FabLabCasaCorsini/aqp_sensors/README.md

# aqp_sensors
Software components for the Aquaponic project - Forked in Casa Corsini github
