FabLabCasaCorsini/aqp_sensors/hydra open souce project/v.02/Hydra OSP.brd

## EAGLE design hydra open souce project/v.02/Hydra OSP.brd (2017-07-12)

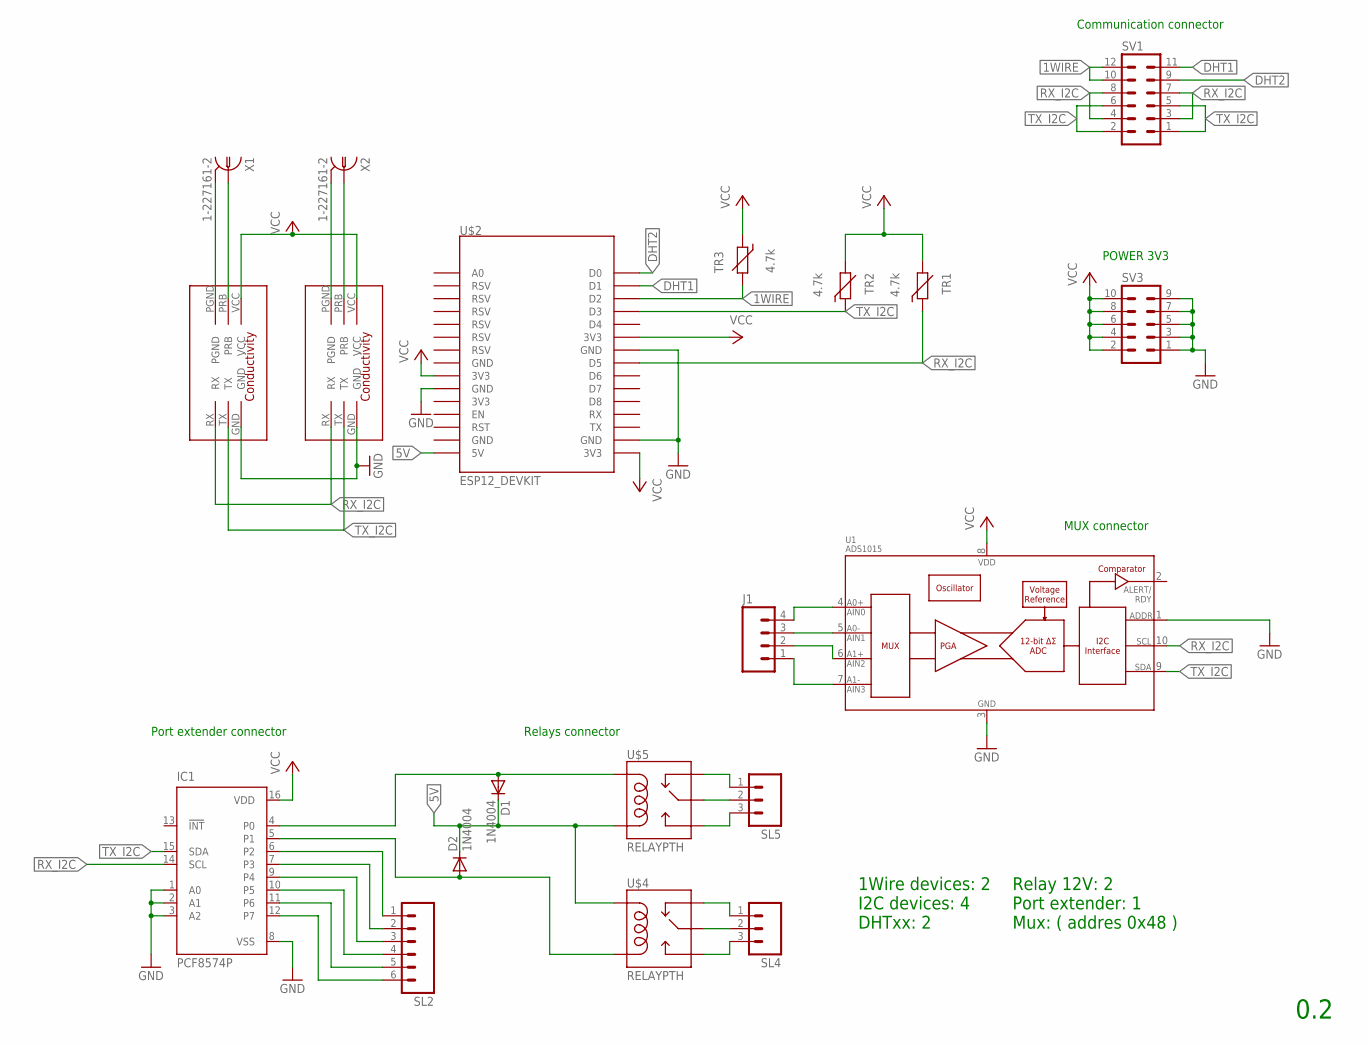
[picture p1: schematic Hydra OSP.sch]

Parts:
D1, D2: 1N4004; DO41-10
IC1: PCF8574P; DIL16
J1: M04LOCK; 1X04_LOCK
SL2: M06; 06P
SL4, SL5: M03; 03P
SV1: MA06-2
SV3: MA05-2
TR1, TR2, TR3: 4.7k; R-5
U1: ADS1015; MSOP10
U$1, U$3: ATLSCI_COND; ATLAS_SCI_COND
U$2: ESP12_DEVKIT
U$4, U$5: RELAYPTH; SRD-05VDC-SL-C
X1, X2: 1-227161-2; AMP_227161

Connections:
1WIRE: SV1.10, SV1.12, TR3.2, U$2.D2
5V: D1.C, D2.C, U$2.5V, U$4.COIL1, U$5.COIL0
DHT1: SV1.11, U$2.D1
DHT2: SV1.9, U$2.D0
GND: IC1.1 (A0), IC1.2 (A1), IC1.3 (A2), IC1.8 (VSS), SV3.1, SV3.3, SV3.5, SV3.7, SV3.9, U1.1 (ADDR), U1.3 (VSS), U$1.GND, U$2.GND@0 (GND), U$2.GND@2 (GND), U$2.GND@3 (GND), U$3.GND
unnamed: U$1.PGND, X1.2
unnamed: U$1.PRB, X1.1
unnamed: U$3.PRB, X2.1
unnamed: U$3.PGND, X2.2
unnamed: D1.A, IC1.4 (P0), U$5.COIL1
unnamed: D2.A, IC1.5 (P1), U$4.COIL0
unnamed: SL4.1, U$4.SWCLOSED (SWCLOSE)
unnamed: SL4.2, U$4.SWCOMMON
unnamed: J1.4, U1.4 (AIN0)
unnamed: J1.3, U1.5 (AIN1)
unnamed: J1.2, U1.6 (AIN2)
unnamed: J1.1, U1.7 (AIN3)
unnamed: IC1.6 (P2), SL2.1
unnamed: IC1.7 (P3), SL2.2
unnamed: IC1.9 (P4), SL2.3
unnamed: IC1.10 (P5), SL2.4
unnamed: IC1.11 (P6), SL2.5
unnamed: IC1.12 (P7), SL2.6
unnamed: SL4.3, U$4.SWOPEN
unnamed: SL5.1, U$5.SWCLOSED (SWCLOSE)
unnamed: SL5.2, U$5.SWCOMMON
unnamed: SL5.3, U$5.SWOPEN
RX_I2C: IC1.14 (SCL), SV1.3, SV1.4, SV1.7, SV1.8, TR1.1, U1.10 (SCL), U$1.RX, U$2.D5, U$3.RX
TX_I2C: IC1.15 (SDA), SV1.1, SV1.2, SV1.5, SV1.6, TR2.1, U1.9 (SDA), U$1.TX, U$2.D3, U$3.TX
VCC: IC1.16 (VDD), SV3.2, SV3.4, SV3.6, SV3.8, SV3.10, TR1.2, TR2.2, TR3.1, U1.8 (VDD), U$1.VCC, U$2.3V3@1 (3V3), U$2.3V3@2 (3V3), U$2.3V3@3 (3V3), U$3.VCC

Notes on the sheet:
1Wire devices: 2 I2C devices: 4 DHTxx: 2
0.2
POWER 3V3
Communication connector
Port extender connector
Relays connector
Relay 12V: 2 Port extender: 1 Mux: ( addres 0x48 )
MUX connector

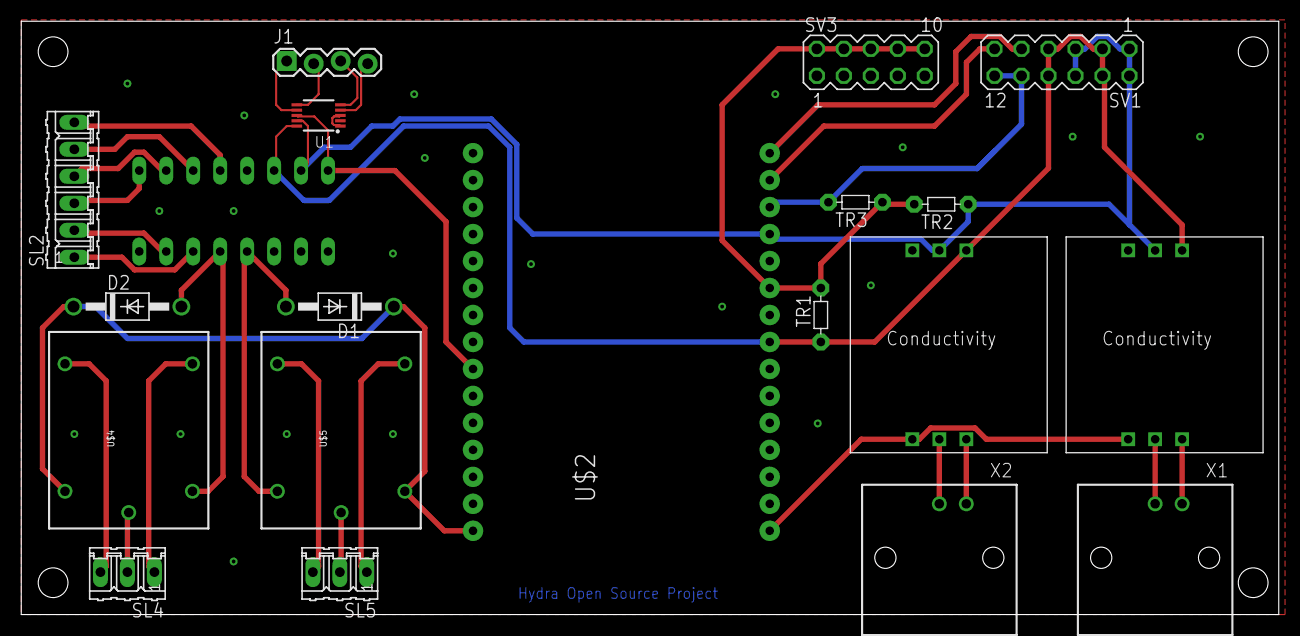
[picture p2: board Hydra OSP.brd from above]

Board: 2 copper layers, 118.4 x 55.9 mm, 20 parts (1 on the bottom side), 30 nets.
