FabLabCasaCorsini/aqp_sensors/(commit log)

2017-07-12 pcb v02
    [Hydra OSP.brd, Hydra OSP.sch]
2018-01-24 WiFi manager
    This version is acutely on the PCB board.
2018-02-05 Fixed new version of OneWire libray
    [esp_code.ino]
2018-02-12 New calibration parameters for pH
