FabLabCasaCorsini/aqp_sensors/(notices)

Notices in the files:
parts and their libraries:
SparkFun-AnalogIC: Licensing:Creative Commons ShareAlike 4.0 International - https://creativecommons.org/licenses/by-sa/4.0
